mumme74/wire_tracer/README.md

# wire_tracer
Hardware tool to trace wires 

No uC involved, driven by a 9V battery
Features:
  * Soft turn on, auto shutoff
  * sender and reciever
