mumme74/wire_tracer/wire_tracer_sender/hardware.ods

name | partno | qty
box 9v | 377-1656-ND | 1
