mumme74/wire_tracer/wire_tracer_reciever/wire_tracer_reciever.sch

## KiCad design wire_tracer_reciever/wire_tracer_reciever.sch (2016-03-29)

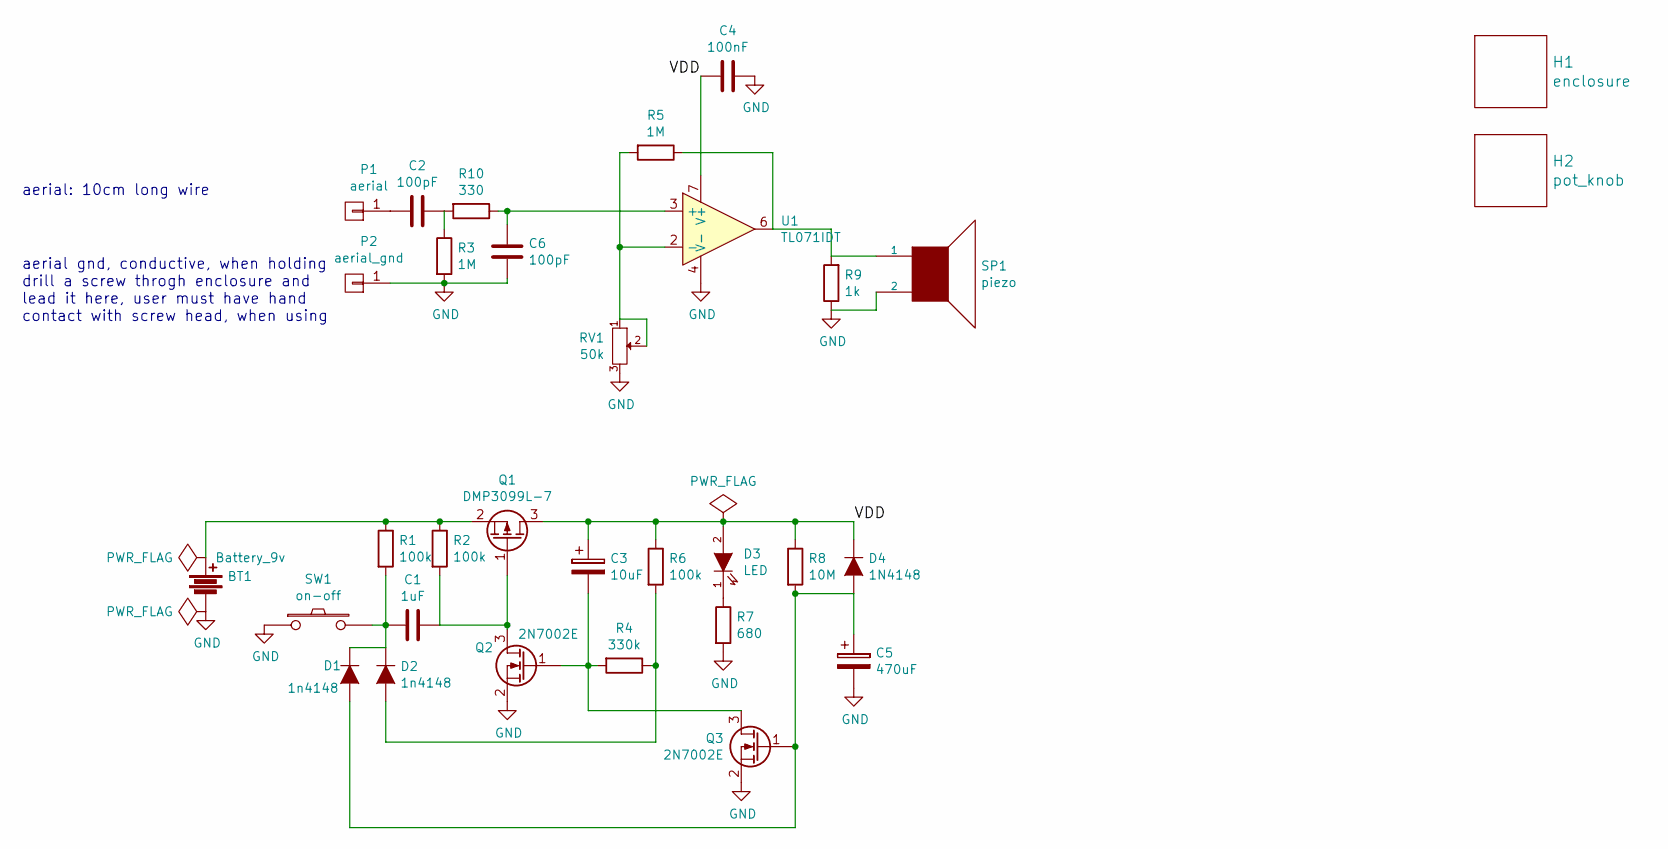
[picture p1: schematic wire_tracer_reciever.sch]

Parts:
BT1: Battery_9v; SolderWirePad_2x_1-2mmDrill; digikey BS6I-ND
C1: 1uF; R_1206_HandSoldering; digikey 1276-1068-1-ND
C2, C6: 100pF; R_1206_HandSoldering; digikey 1276-2802-1-ND
C3: 10uF; R_1206_HandSoldering; digikey 478-8237-2-ND
C4: 100nF; R_1206_HandSoldering; digikey 399-1249-1-ND
C5: 470uF; c_elec_8x10; digikey 493-2181-1-ND
D1, D2: 1n4148; SOD-123; digikey 1N4148WTPMSTR-ND
D3: LED; LED-5MM; digikey 365-1203-ND
D4: 1N4148; SOD-123; digikey 1N4148WTPMSTR-ND
H1: enclosure; digikey 377-1649-ND
H2: pot_knob; digikey GH7628-ND
P1: aerial; SolderWirePad_single_1-2mmDrill
P2: aerial_gnd; SolderWirePad_single_1-2mmDrill
Q1: DMP3099L-7; SOT-23_Handsoldering; digikey DMP3099L-7DICT-ND
Q2, Q3: 2N7002E; SOT-23_Handsoldering; digikey 2N7002ECT-ND
R1, R2, R6: 100k; R_1206_HandSoldering; digikey P100KFCT-ND
R3, R5: 1M; R_1206_HandSoldering; digikey 311-1.00MFRCT-ND
R4: 330k; R_1206_HandSoldering; digikey 311-330KFRCT-ND
R7: 680; R_1206_HandSoldering; digikey 311-680FRCT-ND
R8: 10M; R_1206_HandSoldering; digikey 311-10.0MFRCT-ND
R9: 1k; R_1206_HandSoldering; digikey 311-1.00KFRCT-ND
R10: 330; R_1206_HandSoldering; digikey 311-330FRCT-ND
RV1: 50k; PTV09A; digikey PTV09A-4025F-B503-ND
SP1: piezo; PS1420; digikey 445-2526-3-ND
SW1: on-off; SW_TH_Tactile_Omron_B3F-10xx; digikey 450-1642-ND
U1: TL071IDT; SOIC-8_3.9x4.9mm_Pitch1.27mm; digikey 497-2199-1-ND

Connections:
GND: BT1.2, C4.1, C5.2, C6.2, P2.1, Q2.2 (S), Q3.2 (S), R3.2, R7.2, R9.1, RV1.3, SP1.2, SW1.1, U1.4 (V-)
unnamed: BT1.1, Q1.2 (S), R1.1, R2.1
unnamed: C1.1, Q1.1 (G), Q2.3 (D), R2.2
unnamed: C1.2, D1.1 (K), D2.1 (K), R1.2, SW1.2
unnamed: C2.1, R3.1, R10.2
unnamed: C2.2, P1.1
unnamed: C3.2, Q2.1 (G), Q3.3 (D), R4.2
unnamed: C5.1, D1.2 (A), D4.2 (A), Q3.1 (G), R8.2
unnamed: C6.1, R10.1, U1.3 (+)
unnamed: D2.2 (A), R4.1, R6.2
unnamed: D3.1 (K), R7.1
unnamed: R5.1, R9.2, SP1.1, U1.6
unnamed: R5.2, RV1.1, RV1.2, U1.2 (-)
VDD: C3.1, C4.2, D3.2 (A), D4.1 (K), Q1.3 (D), R6.1, R8.1, U1.7 (V+)

Notes on the sheet:
aerial: 10cm long wire
aerial gnd, conductive, when holding drill a screw throgh enclosure and lead it here, user must have hand contact with screw head, when using
