mumme74/wire_tracer/wire_tracer_sender/wire_tracer_sender.sch

## KiCad design wire_tracer_sender/wire_tracer_sender.sch (2016-03-29)

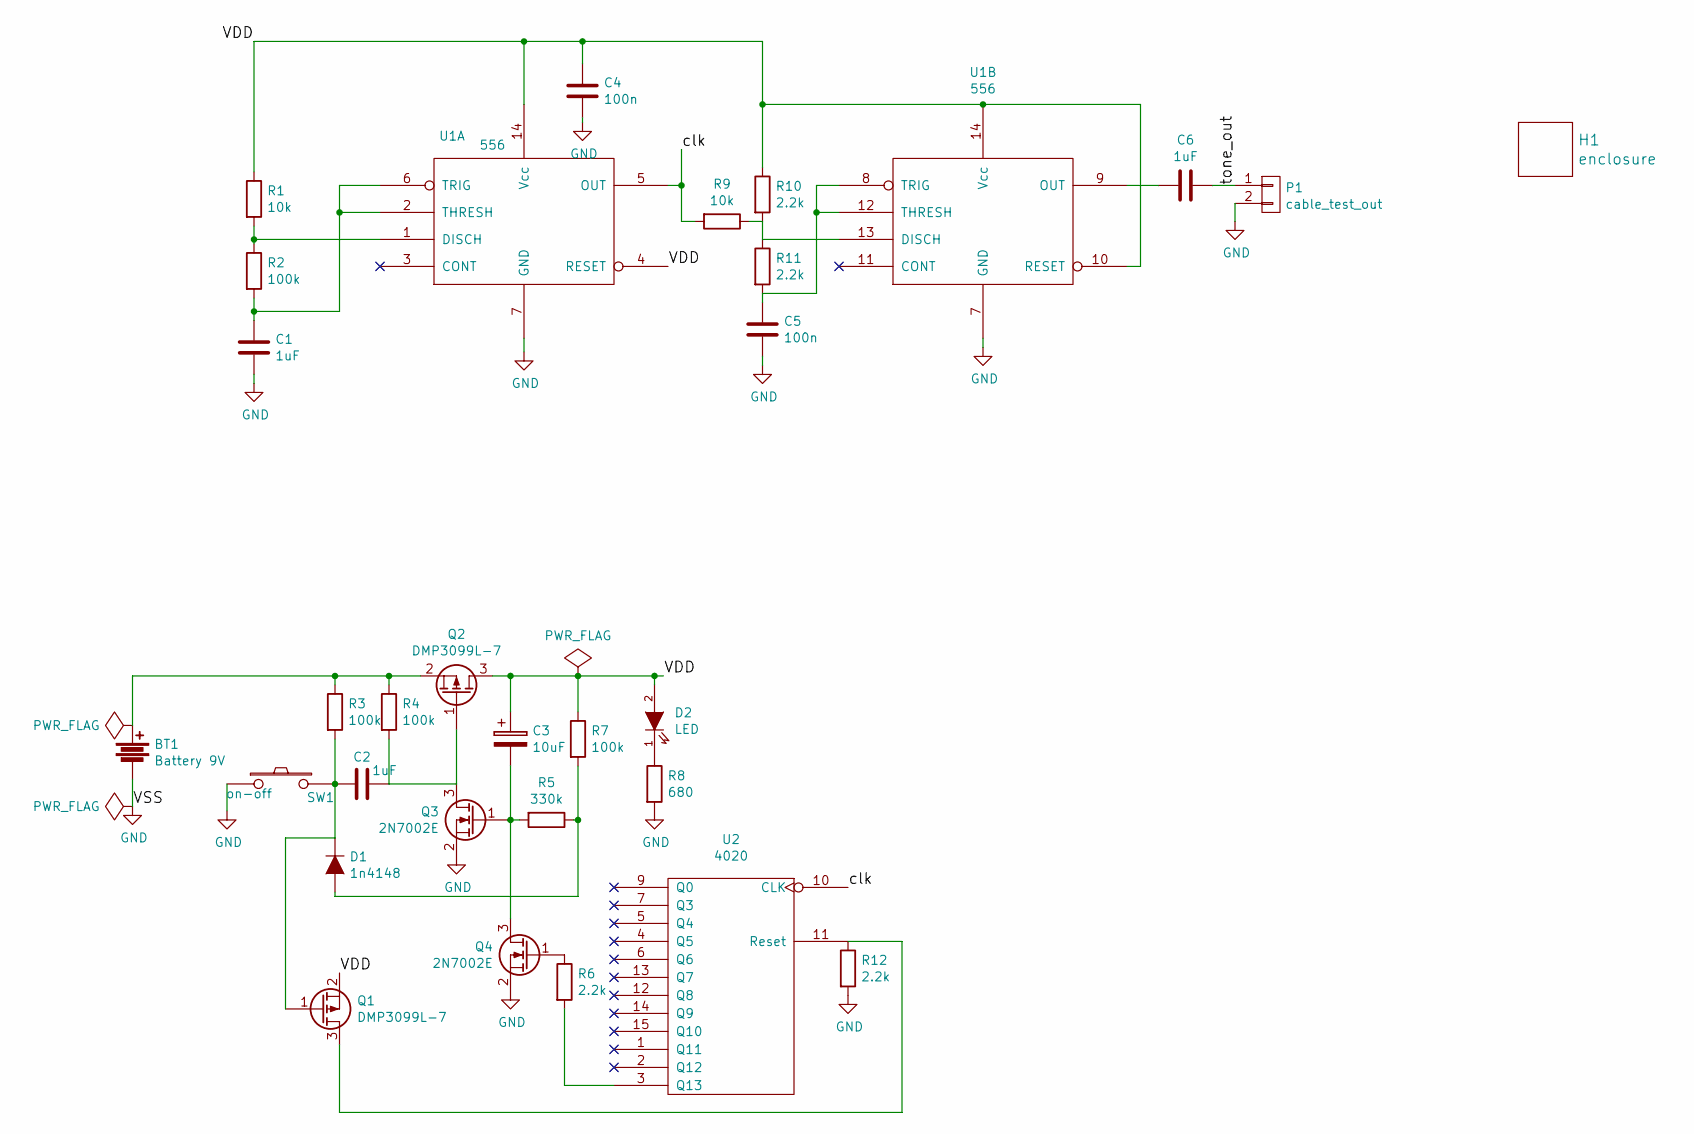
[picture p2: schematic wire_tracer_sender.sch]

Parts:
BT1: Battery 9V; SolderWirePad_2x_1-2mmDrill; digikey BS6I-ND
C1, C2, C6: 1uF; C_1206_HandSoldering; digikey 1276-1068-1-ND
C3: 10uF; C_1206_HandSoldering; digikey 478-8237-2-ND
C4, C5: 100n; C_1206_HandSoldering; digikey 399-1249-1-ND
D1: 1n4148; SOD-123; digikey 1N4148WTPMSTR-ND
D2: LED; LED-5MM; digikey 365-1203-ND
H1: enclosure; digikey 377-1649-ND
P1: cable_test_out; SolderWirePad_2x_1-5mmDrill
Q1, Q2: DMP3099L-7; SOT-23_Handsoldering; digikey DMP3099L-7DICT-ND
Q3, Q4: 2N7002E; SOT-23_Handsoldering; digikey 2N7002ECT-ND
R1, R9: 10k; R_1206_HandSoldering; digikey 311-10.0KFRCT-ND
R2, R3, R4, R7: 100k; R_1206_HandSoldering; digikey P100KFCT-ND
R5: 330k; R_1206_HandSoldering; digikey 311-330KFRCT-ND
R6, R10, R11, R12: 2.2k; R_1206_HandSoldering; digikey 311-2.20KFRCT-ND
R8: 680; R_1206_HandSoldering; digikey 311-680FRCT-ND
SW1: on-off; SW_TH_Tactile_Omron_B3F-10xx; digikey 450-1642-ND
U1: 556; SOIC-14_3.9x8.7mm_Pitch1.27mm; digikey 296-26240-1-ND
U2: 4020; SOIC-16_3.9x9.9mm_Pitch1.27mm; digikey 497-7235-1-ND

Connections:
GND: BT1.2, C1.2, C4.2, C5.2, P1.2, Q3.2 (S), Q4.2 (S), R8.2, R12.2, SW1.1, U1.7 (GND)
unnamed: BT1.1, Q2.2 (S), R3.1, R4.1
unnamed: C1.1, R2.2, U1.2 (THRESH), U1.6 (TRIG)
unnamed: C2.1, Q2.1 (G), Q3.3 (D), R4.2
unnamed: C2.2, D1.1 (K), Q1.1 (G), R3.2, SW1.2
unnamed: C3.2, Q3.1 (G), Q4.3 (D), R5.2
unnamed: C5.1, R11.2, U1.8 (TRIG), U1.12 (THRESH)
unnamed: C6.2, U1.9 (OUT)
unnamed: D1.2 (A), R5.1, R7.2
unnamed: D2.1 (K), R8.1
unnamed: Q1.3 (D), R12.1, U2.11 (Reset)
unnamed: Q4.1 (G), R6.1
unnamed: R1.2, R2.1, U1.1 (DISCH)
unnamed: R6.2, U2.3 (Q13)
unnamed: R9.1, R10.2, R11.1, U1.13 (DISCH)
VDD: C3.1, C4.1, D2.2 (A), Q1.2 (S), Q2.3 (D), R1.1, R7.1, R10.1, U1.4 (RESET), U1.10 (RESET), U1.14 (Vcc)
clk: R9.2, U1.5 (OUT), U2.10 (CLK)
tone_out: C6.1, P1.1
